CanyoneroRobotics/TFM/README.md

# TFM:
* Hardware
* Software
* Educational
