CanyoneroRobotics/TFM/canyonero_description/meshes/canyonero_wheel_collision.stl

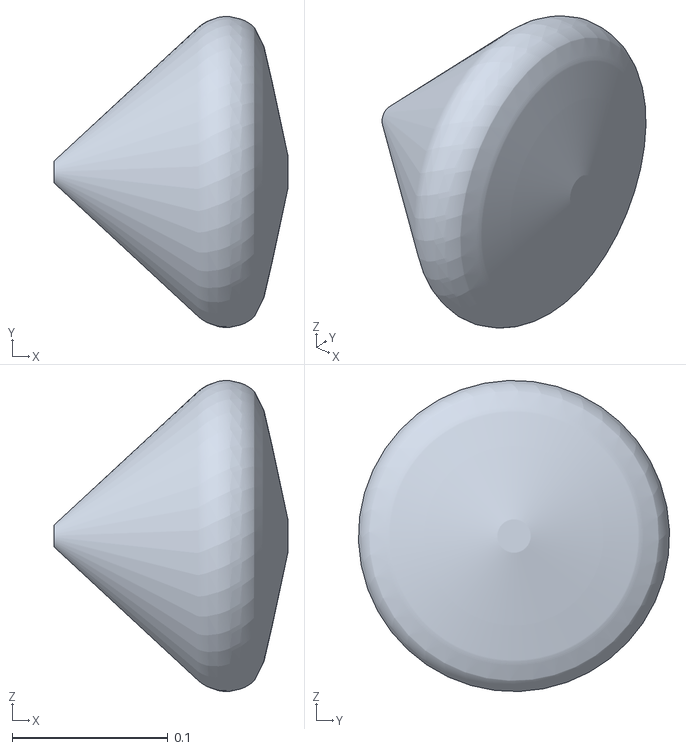
[picture p1: CAD file, 2016-08-30]
canyonero_description/meshes/canyonero_wheel_collision.stl
0.15 x 0.2 x 0.2
