CanyoneroRobotics/TFM/canyonero_description/meshes/canyonero_plates_collision.stl

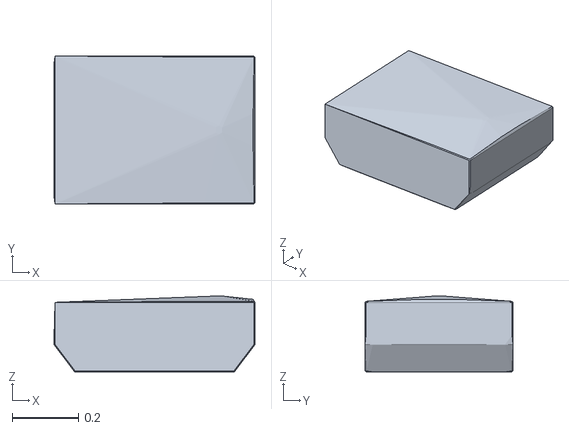
[picture p2: CAD file, 2016-08-30]
canyonero_description/meshes/canyonero_plates_collision.stl
0.606 x 0.446 x 0.229
