CanyoneroRobotics/TFM/canyonero_description/meshes/9dof_razor_imu.stl

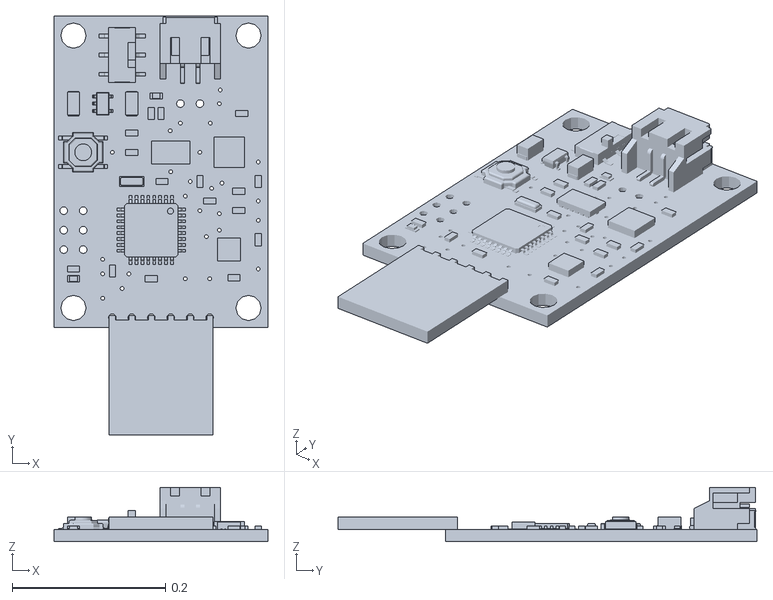
[picture p3: CAD file, 2016-08-07]
canyonero_description/meshes/9dof_razor_imu.stl
0.279 x 0.547 x 0.071
