CanyoneroRobotics/TFM/canyonero_description/meshes/kinect.stl

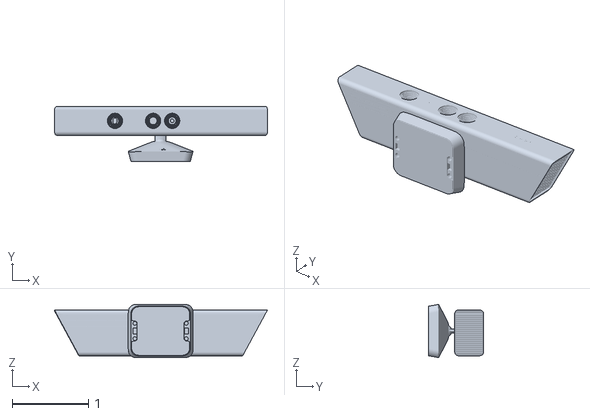
[picture p4: CAD file, 2016-08-07]
canyonero_description/meshes/kinect.stl
2.79 x 0.725 x 0.7
