CanyoneroRobotics/TFM/canyonero_description/meshes/arduino_mount.stl

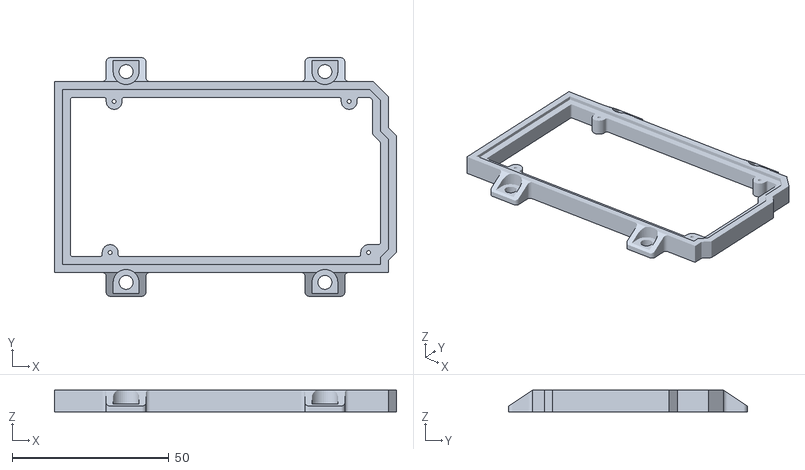
[picture p5: CAD file, 2016-08-05]
canyonero_description/meshes/arduino_mount.stl
109.2 x 76.2 x 6.99
