CanyoneroRobotics/TFM/canyonero_description/meshes/rpi.stl

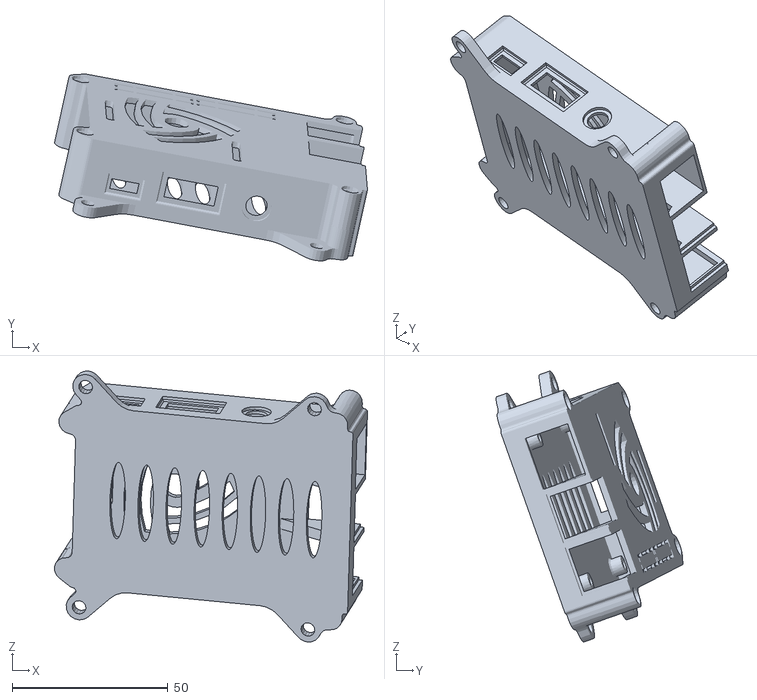
[picture p6: CAD file, 2016-08-05]
canyonero_description/meshes/rpi.stl
100.4 x 59.9 x 86.9
