CanyoneroRobotics/TFM/canyonero_description/meshes/Adaptador_roda_eix_18.stl

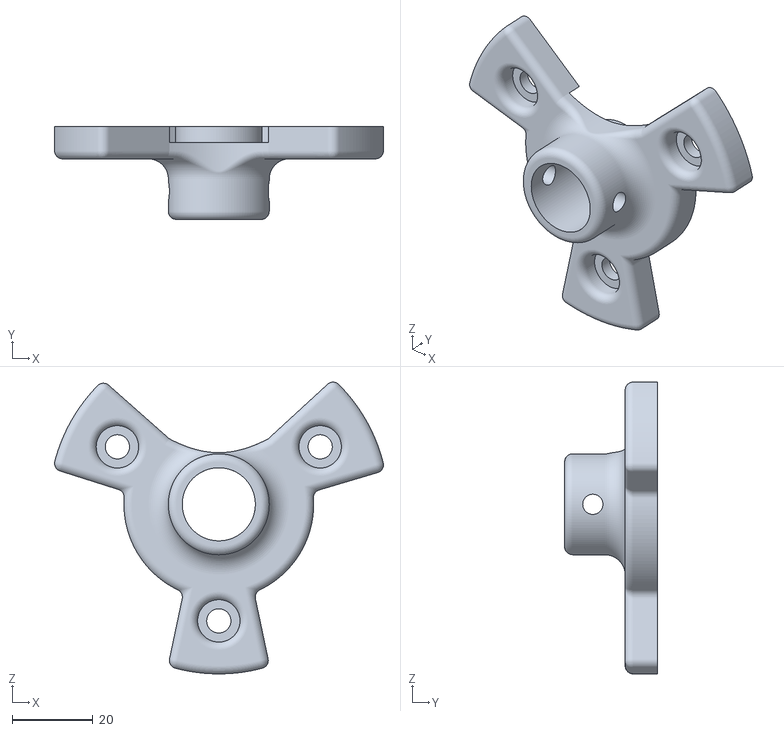
[picture p7: CAD file, 2016-08-05]
canyonero_description/meshes/Adaptador_roda_eix_18.stl
81.5 x 23.0 x 72.3
