CanyoneroRobotics/TFM/(threads)

Thread 1 (2016-05-19):

Raspberry Pi 3 Raspbian installation and basic configuration

simium, 2016-05-19:
Follow: https://wiki.ubuntu.com/ARM/RaspberryPi

simium, 2016-05-23:
The Ubuntu image available for the Pi3 is not official and there's a lack of support for some functionality (wifi configuration, partition resize to use the whole SD card... )

I'm thinking about switching to Raspbian, which is official, provided by the Raspberry people, and can run ROS Indigo: http://www.jonathanfritz.ca/2015/10/24/installing-ros-on-a-raspberry-pi/

Are we ok with using ROS Indigo? Do you prefer Jade? There's a short list of differences: http://wiki.ros.org/Distributions

marcgenevat, 2016-05-23:
As we talked on Thursday with German, Indigo is the most stable version and it will have support until 2019, so I think it's our best option for educational purpose.

So, for me, go for it! ;)

oriolorra, 2016-05-23:
If Raspbian image is official and supports ROS Indigo (as German said), it is fine.

I agree!

simium, 2016-05-23:
Let's start with Indigo, we can move to Jade later if @oriolorra thinks we need a more recent version of Gazebo.

oriolorra, 2016-05-23:
I think that we could manage it with the actual version of Gazebo. A lot of simulator are implemented with it, like Husky of Clearpath Robotics.

simium, 2016-05-23:
Agree!

marcgenevat, 2016-05-23:
Let's do it then! Look forward to see if you succeed with the installation. Let us know if you have problems, but you should be fine.

simium, 2016-05-23:
We will use Ubuntu in the future on-board computer (the Intel NUC), but for now we are going to use Raspbian: https://www.raspbian.org/

Closed 2016-07-25.

Thread 2 (2016-05-19):

Raspberry Pi 3 ROS Indigo installation and basic configuration

simium, 2016-05-19:
Follow: http://wiki.ros.org/jade/Installation/UbuntuARM

marcgenevat, 2016-05-19:
Daleeee Juampe, que ja ho tens tot!

simium, 2016-05-23:
Finally I've chosen Indigo over Jade because of its stability and the availability of packages for Raspbian.

See: http://wiki.ros.org/ROSberryPi/Installing%20ROS%20Indigo%20on%20Raspberry%20Pi

Closed 2016-07-25.

Thread 3 (2016-05-19):

Arduino Mega 2560 ROSSerial installation

simium, 2016-05-19:
See: http://wiki.ros.org/rosserial_arduino/Tutorials

marcgenevat, 2016-05-19:
És el que vam fer amb l'Andreu no? O té alguna diferència?

simium, 2016-05-19:
En principi és el mateix però s'ha de tornar a integrar tot! Per exemple, amb l'Arduino Uno havíem de fer reset manual abans de llençar ROS.

Hem d'anar trobant aquests detalls...

marcgenevat, 2016-05-19:
La majoria de components del tutorial els tenim a Make&Learn, així que si voleu el podem fer i deixar-ho al repo com a introducció a Arduino amb ROS. Potser queda bé de cara a la memòria.

Se'm acudeix que podríem posar algun sensor i actuador bàsic al Canyonero precisament per iniciar-se. No és lu mateix fer un publisher o un listener simplement amb missatges string que poder encendre leds o moure servos o rebre dades d'algun sensor bàsic rollo ultrasons, temperatura, humitat, llum,...

simium, 2016-05-19:
Em sembla perfecte! Proporciona a l'Oriol aquests sensors ASAP! :P

marcgenevat, 2016-05-19:
Quins sensors i actuadors posaríeu doncs?

Molaria tenir dades de:

- IMU
- GPS
- Visió (Kinect/RealSense)
- Odometria (Encoders)
- Ultrasons?
- ...

Pel que fa actuadors:

- Servo per donar-li YAW al sensor d'ultrasons?
- Tira de leds rollo neones? XD
- LEDs per indicar el nivell de bateria?
- Pantalla LCD?
- ...

Ja direu què us molaria i mirem d'aconseguir-ho, a través de la meva empresa o per on sigui.

oriolorra, 2016-05-23:
Done!

motor controlled with Joy and get encoder ->( commit 60addb70302a5986b7fde6990bfda8de4252f9d3)

Thread 4 (2016-05-19):

Arduino Mega 2560 + Motor shield integration

simium, 2016-05-19:
See: https://learn.adafruit.com/adafruit-motor-shield-v2-for-arduino/using-dc-motors

marcgenevat, 2016-05-19:
Us passo el codi que vaig utilitzar en el projecte de la plataforma omnidireccional de tres rodes que controlavem amb LeapMotion la qual tenia un parell de les shield de Adafruit. Espero que et serveixi @oriolorra!

`#include <Wire.h>
#include <Adafruit_MotorShield.h>
#include "utility/Adafruit_PWMServoDriver.h"

Adafruit_MotorShield AFMS = Adafruit_MotorShield();

Adafruit_DCMotor *myMotor1 = AFMS.getMotor(1);
Adafruit_DCMotor *myMotor2 = AFMS.getMotor(2);
Adafruit_DCMotor *myMotor3 = AFMS.getMotor(3);

char movement;
int vel = 255;

void setup() {
  Serial.begin(9600);           // set up Serial library at 9600 bps
  Serial.println("Adafruit Motorshield v2 - DC Motor test!");

  AFMS.begin();  // create with the default frequency 1.6KHz
  //AFMS.begin(1000);  // OR with a different frequency, say 1KHz
}

void Forward() {
  myMotor1->setSpeed(vel);
  myMotor2->setSpeed(vel);

  myMotor1->run(FORWARD);
  myMotor2->run(BACKWARD);
  myMotor3->run(RELEASE);
  }

void Backward() {
  myMotor1->setSpeed(vel);
  myMotor2->setSpeed(vel);

  myMotor1->run(BACKWARD);
  myMotor2->run(FORWARD);
  myMotor3->run(RELEASE);
  }

void Left() {
  myMotor1->setSpeed(vel);
  myMotor2->setSpeed(vel);
  myMotor3->setSpeed(vel);

  myMotor1->run(FORWARD);
  myMotor2->run(FORWARD);
  myMotor3->run(BACKWARD);
  }

void Right() {
  myMotor1->setSpeed(vel);
  myMotor2->setSpeed(vel);
  myMotor3->setSpeed(vel);

  myMotor1->run(BACKWARD);
  myMotor2->run(BACKWARD);
  myMotor3->run(FORWARD);
  }

void Left_Rotation() {
  myMotor1->setSpeed(vel);
  myMotor2->setSpeed(vel);
  myMotor3->setSpeed(vel);

  myMotor1->run(FORWARD);
  myMotor2->run(FORWARD);
  myMotor3->run(FORWARD);
  }

void Right_Rotation() {
  myMotor1->setSpeed(vel);
  myMotor2->setSpeed(vel);
  myMotor3->setSpeed(vel);

  myMotor1->run(BACKWARD);
  myMotor2->run(BACKWARD);
  myMotor3->run(BACKWARD);
  }

void Break() {
  myMotor1->run(RELEASE);
  myMotor2->run(RELEASE);
  myMotor3->run(RELEASE);
  }

void loop() {
  uint8_t i;
  while(!Serial.available());
  movement = Serial.read();
  switch (movement) {
    case 'B':
      Backward();
      while(movement == 'B') {movement = Serial.read();}
      Break();
      break;
    case 'F':
      Forward();
      while(movement == 'F') {movement = Serial.read();}
      Break();
      break;
    case 'L':
      Left();
      while(movement == 'L') {movement = Serial.read();}
      Break();
      break;
    case 'R':
      Right();
      while(movement == 'R') {movement = Serial.read();}
      Break();
      break;
    case 'X':
      Left_Rotation();
      while(movement == 'X') {movement = Serial.read();}
      Break();
      break;
    case 'Y':
      Right_Rotation();
      while(movement == 'Y') {movement = Serial.read();}
      Break();
      break;
    default:
      Break();
      break;
      }
}`

oriolorra, 2016-05-20:
See: [http://www.dfrobot.com/wiki/index.php/Encoder_Adapter_FIT0324](url)

oriolorra, 2016-05-23:
Done!

motor controlled with Joy and get encoder ->( commit 60addb70302a5986b7fde6990bfda8de4252f9d3)

Thread 5 (2016-05-20):

Frame cover plates

marcgenevat, 2016-05-20:
Design, selection of materials and thin

marcgenevat, 2016-05-23:
We're going to combine aluminium plates with methacrilate plates. So the first floor (bottom, frontal and back angles) that have to be more resistant will be covered with aluminium and the second floor will be covered with methacrilate plates, maybe transparent red, in order to protect but at the same time be possible to see through them from the outside.

We should build a kind of door or something easily removable at the back side to have a quick access to the inside of the robot.

marcgenevat, 2016-06-05:
All the plates are done except the up and back ones, due to at the beginning maybe we won't have them to ease the manipulation of the components inside the robot.

Thread 6 (2016-05-20):

Joystick -> ROS

oriolorra, 2016-05-20:
Trying to integrate the Joystick (using NETWAY NW499 ) with ROS.
Be able to read some ros message.

see: [http://wiki.ros.org/joy/Tutorials](url)

simium, 2016-05-23:
We could design a set of functions that can be triggered through the gamepad, e.g. turning on/off LEDs or activating a warning buzzer.

marcgenevat, 2016-05-23:
Interesting... :P

oriolorra, 2016-05-23:
Done!

motor controlled with Joy and get encoder ->( commit 60addb70302a5986b7fde6990bfda8de4252f9d3)

Thread 8 (2016-05-23):

Components distribution

marcgenevat, 2016-05-23:
We'll have the hardware distributed on the first and second floor and the top (lidar).

First suggestion:

Raspberry PI 3 and IMU should be together and at the center of the robot. The same for the batteries in order to have the gravity center centralized.

Then, the Arduino+shield should be at the second floor, along with the router and the 3D camera, currently the kinect, which it'll be at the frontal side with a gap at the methacrilate plate for the different cameras.

The encoder boards can be at the second floor but below, so don't occupy too much space and the wires can go through a gap on the second floor between the Raspberry PI and the Arduino, where a lot of wires will be able to go through, like the power supply.

The lidar could be at the very frontal top of the robot having the possibility to scan around using a 270º or 360º.

marcgenevat, 2016-05-23:
Maybe we should reconsider the position of the router, so we don't have a lot of space at the second floor, less if we use the kinect. It would be much better using the Real Sense camera, it's much smaller.

simium, 2016-05-23:
As we commented offline, we could set the router as if it was a backpack on the robot's back, that way we could improve the wifi coverage. There are wall mounts available for our WRT54G router, or we could design and print our own :sunglasses: https://www.google.es/search?q=linksys+wrt54g+wall+mount&source=lnms&tbm=isch

marcgenevat, 2016-05-23:
But then the router will be out of the robot, right? With no protection from the outside... Isn't that a problem?

simium, 2016-05-23:
Oh, that's true! For the outdoors applications it would be too dangerous... maybe we could get a smaller router later in the project if free space is a serious issue.

marcgenevat, 2016-05-23:
Yeah... maybe we can find a smaller router that works as good as this one.

Thread 9 (2016-05-26):

Integrate two motors (left&rigth)

oriolorra, 2016-05-26:
Now, we only have integrated one motor. We can control its velocity with the joystick and we read its encoder too.

So, we want to control two motors' velocity and also read the two encoders. Therefore, the Canyonero will be able to go forward, backward and turn.

oriolorra, 2016-06-18:
We have a problem with rosserial and Adafruit_MotorShield library (AFMS). We can not initialise the communication between our PC and Arduino Mega with rosserial. Our thought is that the problem could be that AFMS is using Wire.h library, and it could make interference to rosserial.

oriolorra, 2016-06-22:
I have found the problem. Adafruit_Motorshield uses the library " Wire.h " using the SDA and SCL pins , although, they are free on Arduino Mega , but if we use them for interruptions could create interference with rosserial and Adafruit_Motorshield.

oriolorra, 2016-07-22:
Now with the encoders ticks, I have to publish a nav_msgs::Odometry. So, I have to calculate linear and angular velocities, and then calculate position and orientation.

Also, I need to transform this values, because they have been calculated on 'tf->odom', and I would represent it on 'tf->baselink'. So, I have to send a 'TransformBroadcaster' with the right parameters.

oriolorra, 2016-08-12:
We have a problem. Each encoder gives us a different ticks count per rotation, so we will have to do some calibration for each encoder.

Thread 11 (2016-06-05):

Wheels + motors

marcgenevat, 2016-06-05:
This is the tricky part of the design and the system. So the wheels are so big and have a 20mm hole for the shaft so we'll have to adapt it to the motor. I have some ideas, one is with a rigid part and the other involves a flexible part that could be use as a suspension for the robot. We may talk about it with our tutors and test it. We want to do this part well done, simple and resistant.

marcgenevat, 2016-06-18:
Once I replicated the rim of the wheel, I've designed an adaptor to joint the motor shaft to the wheel with a setscrew of M4, taking advantage of its three screws of M6. According to the assembly (rim+adaptor), this adaptor could work. I'll try to replicate the whole wheel, so I can use it at the full assembly all together.

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

We should try it first 3D printing a prototype and then mechanize it with the UVic's CNC.

Closed 2016-07-23.

Thread 14 (2016-06-18):

Adding Kinect

marcgenevat, 2016-06-18:
Instead of place the kinect inside the robot, where it will be too low from the ground and we won't be able to see a full skeleton (important if we want to implement a follower app), the kinect should be at the very top of the robot. To do that, I've designed a support to joint the kinect with 4 screws to the top methacrylate plate. Besides, the two frontal screws could be placed at the frontal aluminium bar.

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

marcgenevat, 2016-06-18:
Assembly:
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

A provisional hole to the methacrylate has been done in order to pass wires:

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

Closed 2016-07-23.

Thread 16 (2016-07-06):

Aluminium profiles joints

marcgenevat, 2016-07-06:
All the needed joints have already been designed with PTC Creo and now we're 3D printing prototypes to test them with the profiles.

The first test was pretty good. We had to make the holes bigger with a drill due to the 3d printer tolerances. Besides, we're thinking to add some flanges in order to avoid rotations atthe profiles so we have a very strong and robust chassis.

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

During this week we'll 3d print the new prototypes with the changes we've mentioned. Once we have these final designs, we'll be able to start cutting the profiles and building the chassis, at least the first and second floors, which would be the skeleton of the robot.

carlosjoserg, 2016-07-07:
:+1:

Closed 2016-07-23.

Thread 17 (2016-07-08):

Install ORB-SLAM2 & use it with ROS

oriolorra, 2016-07-08:
ORB-SLAM2 has been already installed, and it is also working. We can launch it with a 'rosrun'. But once it is running, is not showing any 'rostopic'. It would be nice to implement some simple topics to use them.

I have send an email to the author of ORB-SLAM2 to see if he could give me some advised, how to implement it.

oriolorra, 2016-07-22:
After going to a reading group at IRI and talking with Andreu, I have some clear ideas to know how to modify the code of ORB-SLAM2. I am going to modify the ROS example for RGB-D, and I will publish a nav_msgs::Odometry based on the Transformation matrix of camera. With the Transformation Matrix, I could get position and orientation, and then calculate linear and angular velocities.

Thread 18 (2016-07-16):

Canyonero's chassis

marcgenevat, 2016-07-16:
I'm passing all the designs and redoing all the assemblies with Fusion 360. I really like this cloud-based 3D CAD software and I think it could be very useful to learn and work with this software in this kind of project.

Now I've got all the parts I designed imported in my Fusion 360 Canyonero's project and almost all the necessary parts to build all the system.

I've made the assembly of the chassis so far. Here are some render pictures:

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

I'm thinking to add some crossbars aluminum profiles in order to increse its robustness, at least at the bottom part. What do you guys think?

This next week I'll cut and thread all the necessary profiles and build the chassis, so the joints are already tested and work.

At the design part, tomorrow I'd like to design the missing pieces at the motion part, I have almost everything, and assemble it. So maybe next week I'll be able to have the full assembly and start to build the real one and the URDF.

marcgenevat, 2016-07-18:
Just cut and thread all the necessary profiles this morning as I planned.

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

Next steps: Make the necessary holes to the profiles, print the missing profile joints and build the chassis. Hopefully I'll be able to do all of that tomorrow.

I will ask Polpisa if they can provide us the pro-mechanical parts that we need: the double bearing and the shaft coupler. Maybe I'll do the wheel's 8mm shaft by myself.

marcgenevat, 2016-07-19:
Today I've could the holes at the "perfil_pilar" and at the "perfil_travesser_horitzontal" and printed the missing joints from the bottom part. So I could already assemble the bottom and the top part:

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

I went to Polpisa to ask if they can provide us a double bearing and a shaft coupler as ones that we need but they only can provide us maybe the shaft coupler. While I'm still waiting for the price I think I'm going to build it by myself and buy this simple bearing:

http://es.rs-online.com/web/p/unidades-de-rodamientos-soportes-de-eje-y-accesorios/3112639/

I've designed a support to be printed in order to elevate the bearing so it's at the same height with the shaft:

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

Next steps: Print the joints from the middle part so I can assemble the whole chassis, make the aluminum motor plates with the CNC and finish the design of the motion system, it's almost done.

Thread 19 (2016-07-22):

Integrate robot_pose_ekf

oriolorra, 2016-07-22:
Once I have the right messages (visual odometry, encoders odometry and imu message). I will be able to integrate this ros package.

Thread 20 (2016-07-23):

Design a 12V-5V-3V3 power supply unit

simium, 2016-07-23:
The Canyonero is a multi-power system with power hungry components like the 4 DC motors or low power components like the Raspberry Pi or the IMU. Thus we must design an efficient PSU that can handle the energy provided by a 12V/10Ah battery and power the several components of the system safely.

Current power needs are:

- 12V/4.8A for the DC motors (handled by the Motor Shield)
- 5V/2A for the Raspberry Pi (which in turn powers the Arduino, plus high CPU load and WiFi increase the power consumption)
- 3.3V/1A for the GPS and the IMU

The 12V will be provided straight from the battery, since the Motor Shield can handle this voltage safely. The 5V and 3.3V voltages will be provided by two LM2576S ICs, which are 3A step-down voltage regulators. They can source plenty of power for the Pi or the sensors.

The battery voltage will be monitored by down-sizing its value by ~3, so we can use the Arduino ADC (10 bits, up to 5V) to read it and use it. Once we know the real battery charge-discharge profile we will model its usage and will provide feedback for the user using LEDs or an LED bar plus a ROS message.

The battery power should be cut at any given moment for safety reasons. An emergency stop button will be added to the Canyonero so the operator can halt the robot when desired. This button will be Normally-Closed, and will open the circuit once it's pressed.

simium, 2016-07-25:
This is the schematics of a prototype for a 12V/5V/3V3 PSU that can provide power for DC motors, the Kinect, the Raspberry Pi...

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

This is the final layout for v1.0:
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

I've ordered it and it will be fabricated by an online service called [OSHPark](https://oshpark.com/), which I've worked with before. This is how the final board will look:
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

The electronic parts will be bought from [Farnell Spain](http://es.farnell.com/).

Closed 2016-07-25.

Thread 21 (2016-07-23):

Motion system

marcgenevat, 2016-07-23:
The motion system has been causing some troubles from the beginning.

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

Due to the size of the wheel, an adaptador for the saft had to be made. The motor we're using has a very short and small shaft (ø6mm x 14mm) so we had to couple a larger shaft in order to hold and resist the weight of the robot, which it may be pretty heavy.

The first idea was to attach a ø8mm shaft to the motor's shaft with a flexible or rigid coupler. Then, it would have a plastic bearing holding the larger shaft and it would attach to the wheel using the adapter piece created and a grub screw from the inside part of the wheel.

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

After a meeting with my tutor Carlos Rosales, we talked about the importance of accessibility and ease to mount and unmount parts. Also, with Jordi Serra, UVic workshop's chief, talked about simplifying some parts and increasing the resistance of the system with a larger shaft for the wheel.

So, after several options and ideas which its dismissed is going to be explained at the final report, I have decided to design and implement this system:

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

The wheel's shaft is now ø20mm with a socket of ø18mm for the wheel's inside part. As it's that huge, the shaft itself can act as a coupler for the motor's shaft. The wheel's shaft will be attached to the wheel using a single adapter piece from the wheel's outside part with a passing grub screw. There will be an igus ball bearing will be at the middle of the wheel's shaft onto the aluminum profile.

The new wheel's shaft adapter for the outside (has to avoid the tire's air nozzle) looks like that:

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

The whole assembly has this appearance right now:

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

If my tutor Carlos validate this new design, I'm going to build it this next week and start redesigning the plates and covers to improve their accessibility and ease to mount and unmount.

carlosjoserg, 2016-07-23:
LGTM! :+1:

Left a couple of comments on the F360 project.

marcgenevat, 2016-08-03:
last week i had enough time to make all the needed parts to build the motion system.

so now we have the 4 motor plates, the 4 turned shafts and 2 wheel-shaft adapter, i'll have to print two more by myself.

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

in a few days we should receive the igus bearings. then we'll be able to mount the motion system to the chassis.

Thread 22 (2016-09-02):

High pitch noise in video

carlosjoserg, 2016-09-02:
In the video @simium made and @marcgenevat sent me, I hear a high pitch noise when actuating the motors, that is typically caused by a low and audible PWM frequency.

I see you are using the default frequency of 1.6Khz [here](https://github.com/CanyoneroRobotics/TFM/blob/roscontrol/arduino_sketchbook/arduino_canyonero/arduino_canyonero.ino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).

If the H-bridge you have supports a non-audible frequency (>20Khz), then it'd be pleasantly quiet if you set a higher PWM frequency.

If I was mistaken about the noise, then forget this issue.

simium, 2016-09-06:
In this project we are using the Motor Shield v2 by Adafruit, which uses the PCA9865 PWM chip to generate the desired PWM signals for the motors. The problem is that this IC provides a maximum frequency of 1.6Khz (it's actually designed to drive LEDs, not motors, but it keeps costs down)

In a future version of Canyonero we could get better motor drivers that have more pleasant frequencies, but there's not much we can do about this right now with current hardware.

carlosjoserg, 2016-09-06:
:+1:

Closed 2016-09-06.
