CanyoneroRobotics/TFM/(commit log)

2016-05-23 motor controlled with Joy and get encoder
2016-05-25 encoder update
2016-05-25 launch files added & arduino encoder bwd fwd
2016-05-25 Adding kinect drivers
2016-05-25 Uploading kinect drivers
2016-05-30 kinect calibration Issue #10
2016-07-08 TWO encoders working
2016-07-27 encoder msg to Odom msg
2016-08-05 canyonero description created
    [9dof_razor_imu.stl, Adaptador_roda_eix_18.stl, arduino_mount.stl, canyonero.urdf, rpi.stl]
2016-08-05 adding kinect and imu meshes
    [kinect.stl]
2016-08-07 urdf finished, now I have to improve it using xacros and adding gazebo stuff
    [9dof_razor_imu.stl, canyonero.urdf, canyonero2.urdf, kinect.stl]
2016-08-12 arduino update->wheels vel -- canyonero_project -> control&odometry
2016-08-15 just started to use xacro for the urdf
    [canyonero.urdf.xacro, canyonero_base.urdf.xacro, canyonero_plates_collision.stl, canyonero_wheel.urdf.xacro]
2016-08-19 Arduino side implemented. To be tested.
2016-08-22 xacro is done and prepared to start working with the simulation with Gazebo. It's just missing some phisical parameters.
    [canyonero.urdf.xacro, canyonero_base.urdf.xacro, canyonero_imu.urdf.xacro, canyonero_kinect.urdf.xacro, canyonero_properties.urdf.xacro, canyonero_wheel.urdf.xacro]
2016-08-24 adding gazebo stuff
    [canyonero.urdf, canyonero_base.urdf.xacro, canyonero_imu.urdf.xacro, canyonero_kinect.urdf.xacro, canyonero_wheel.transmission.xacro, canyonero_wheel.urdf.xacro, canyonero_wheel_collision.stl]
2016-08-24 Fixing repo with standard ROS package structure.
    [9dof_razor_imu.stl, Adaptador_roda_eix_18.stl, arduino_mount.stl, canyonero.urdf, canyonero.urdf.xacro, canyonero2.urdf, canyonero_base.urdf.xacro, canyonero_plates_collision.stl]
2016-08-26 Debugging the messaging between ROS and Arduino.
2016-08-26 updating canyonero_description
    [canyonero.urdf.xacro, canyonero_base.urdf.xacro, canyonero_imu.urdf.xacro, canyonero_kinect.urdf.xacro, canyonero_plates_collision.stl, canyonero_properties.urdf.xacro, canyonero_wheel.urdf.xacro, canyonero_wheel_collision.stl]
2016-08-26 All 4 motors working!
2016-08-27 updating canyonero_gazebo and canyonero_description at the roscontrol branch
    [canyonero.gazebo.xacro, canyonero.urdf, canyonero.urdf.xacro, canyonero2.urdf, canyonero_base.urdf.xacro, canyonero_imu.urdf.xacro, canyonero_kinect.urdf.xacro, canyonero_properties.urdf.xacro]
2016-08-28 Fixed includes that did not compile under Ubuntu.
    [Arduino.cpp, Arduino.h]
2016-08-28 It moves! (although it seems there is a problem with the axis...)
    [canyonero_base.urdf.xacro, canyonero_wheel.urdf.xacro]
2016-08-28 Preparing sim.launch for the 5 different practices
    [canyonero_properties.urdf.xacro, canyonero_wheel.urdf.xacro]
2016-08-29 Using arduino float for more precision reporting speed.
2016-08-29 Serial communication of float values is tricky so stick to int8_t for speed messages (robot speed is 1.0 m/s max so we can send -100..100 cm/s messages)
2016-08-29 Fix bad serial transfer.
    [Arduino.cpp]
2016-10-10 Updating Canyonero_Gazebo
    [canyonero_base.urdf.xacro, canyonero_wheel.urdf.xacro]
